jtgebert/fpganes_release/documents/README.md

*Four People Generating A Nintendo Entertainment System (FPGANES)*

*Eric Sullivan, Jonathan Ebert, Patrick Yang, Pavan Holla*

<span id="_byhn74w1sckk" class="anchor"></span>Final Report

University of Wisconsin-Madison

ECE 554

Spring 2017

Introduction
============

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

1.  Top Level Block Diagram
    =======================

    1.  Top level description
        ---------------------

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

6.  APU - Generates audio in the NES. However, we did not implement this module.

7.  CHAR RAM/ RAM - Used by the CPU and PPU to store temporary data

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

Data Flow Diagram
-----------------



Figure 1: System level data flow diagram

 Control Flow Diagram
---------------------



Figure 2: System level control flow diagram.

CPU
===

CPU Registers
-------------

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

1.  PC : Program Counter

2.  Accumulator(A) : Keeps track of results from ALU

3.  X : X index register

4.  Y : Y index register

5.  Stack pointer

6.  Status Register : Negative, Overflow, Unused, Break, Decimal, Interrupt, Zero, Carry

    -   Break means that the current interrupt is from software interrupt, BRK

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

There are 6 secondary registers:

1.  AD : Address Register

    -   Stores where to jump to or where to get indirect access from.

2.  ADV : AD Value Register

    -   Stores the value from indirect access by AD.

3.  BA : Base Address Register

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

4.  BAV : BA Value Register

    -   Stores the value from indirect access by BA.

5.  IMM : Immediate Register

    -   Stores the immediate value from the memory.

6.  Offset

    -   Stores the offset value of branch from memory

CPU ISA
-------

The ISA may be classified into a few broad operations:

-   Load into A,X,Y registers from memory

-   Perform arithmetic operation on A,X or Y

-   Move data from one register to another

-   Program control instructions like Jump and Branch

-   Stack operations

-   Complex instructions that read, modify and write back memory.

CPU Addressing Modes
--------------------

Additionally, there are thirteen addressing modes which these operations can use. They are

-   **Accumulator** – The data in the accumulator is used.

-   **Immediate** - The byte in memory immediately following the instruction is used.

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

-   **Zero Page, Y Index** – Same as above but with the Y index register

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

-   **Absolute, Y Index** – Same as above but with the Y index register

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

-   **(Indirect, X)** – A combination of Indirect Addressing and Indexed Addressing

-   **(Indirect), Y** - A combination of Indirect Addressing and Indexed Addressing

CPU Interrupts
--------------

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

CPU Opcode Matrix
-----------------

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

The specific opcode hex values are specified in the Assembler section.

For more information on the opcodes, please refer

[*http://www.6502.org/tutorials/6502opcodes.html*](http://www.6502.org/tutorials/6502opcodes.html)

or

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

CPU Block Diagram
------------------------------------------------------------------------

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

**Instruction flow**

The following table presents a high level overview of how each instruction is handled.

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

**State Machines**

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

Instruction\_type=ARITHMETIC, addressing mode= IMMEDIATE

| state=0 | state=1 | state=2 |
|---|---|---|
| ld\_sel=LD\_INSTR; //instr= memory\_data 
                                           
 pc\_sel=INC\_PC; //pc++                   
                                           
 next\_state=state+1’b1                    | ld\_sel=LD\_IMM;       
                          
  //imm=memory\_data      
                          
  pc\_sel=INC\_PC         
                          
  next\_state=state+1’b1  | alu\_ctrl=DO\_OP\_ADC // execute          
                                              
   src1\_sel=SRC1\_A                          
                                              
   src2\_sel=SRC2\_IMM                        
                                              
   dest\_sel=DEST\_A                          
                                              
   ld\_sel=LD\_INSTR//fetch next instruction  
                                              
   pc\_sel=INC\_PC                            
                                              
   next\_state=1’b1                           |

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

CPU Top Level Interface
-----------------------

| Signal name | Signal Type | Source/Dest | Description |
|---|---|---|---|
| clk | input | | System clock |
| rst | input | | System active high reset |
| nmi | input | PPU | Non maskable interrupt from PPU. Executes BRK instruction in CPU |
| addr\[15:0\]  | output | RAM | Address for R/W issued by CPU |
| dout\[7:0\] | input/ 
               
  output       | RAM         | Data from the RAM in case of reads and and to the RAM in case of writes |
| memory\_read  | output      | RAM         | read enable signal for RAM                                              |
| memory\_write | output      | RAM         | write enable signal for RAM                                             |

CPU Instruction Decode Interface
--------------------------------

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

CPU MEM Interface
-----------------

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

CPU ALU Interface
-----------------

Performs arithmetic, logical operations and operations that involve status registers.

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

### ALU Input Selector

Selects the input1 and input2 for the ALU

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

CPU Registers Interface
-----------------------

Holds all of the registers

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

CPU Processor Control Interface
-------------------------------

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

CPU Enums
---------

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

Picture Processing Unit
=======================

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

PPU Top Level Schematic
-----------------------



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

**Background Renderer:** Responsible for drawing the background data for a scene.

**Sprite Renderer:** Responsible for drawing the sprite data for a scene, and maintaining object attribute memory.

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

PPU Memory Map
--------------



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

PPU CHAROM
----------

-   ROM from the cartridge is broken in two sections

    -   Program ROM

        -   Contains program code for the 6502

        -   Is mapped into the CPU address space by the mapper

    -   Character ROM

        -   Contains sprite and background data for the PPU

        -   Is mapped into the PPU address space by the mapper

PPU Rendering
-------------

-   Pattern Tables

    -   $0000-$2000 in VRAM

        -   Pattern Table 0 ($0000-$0FFF)

        -   Pattern Table 1 ($1000-$2000)

        -   The program selects which one of these contains sprites and backgrounds

        -   Each pattern table is 16 bytes long and represents 1 8x8 pixel tile

            -   Each 8x1 row is 2 bytes long

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

                -   Color\_pixel = {byte2\[0\], byte1\[0\]}

            -   So there can only be 4 colors in any given tile

            -   Rightmost bit is leftmost pixel

    -   Any pattern that has a value of 0 is transparent i.e. the background color



-   Name Tables

    -   $2000-$2FFF in VRAM with $3000-$3EFF as a mirror

    -   Laid out in memory in 32x30 fashion

        -   Think of as a 2d array where each element specifies a tile in the pattern table.

        -   This results in a resolution of 256x240

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

        -   Vertically = horizontal movement

        -   Horizontally = vertical movement

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

    -   Attribute tables

        -   1 byte entries that contains the palette assignment for a 2x2 grid of tiles

> 

-   Sprites

    -   Just like backgrounds sprite tile data is contained in one of the pattern tables

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

-   Object Attribute Memory

    -   256 bytes of dedicated RAM

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

    -   Each object has the following information stored in OAM

        -   X Coordinate

        -   Y Coordinate

        -   Pattern Table Index

        -   Palette Assignment

        -   Horizontal/Vertical Flip

-   Palette Table

    -   Located at $3F00-$3F20

        -   $3F00-$3F0F is background palettes

        -   $3F10-$3F1F is sprite palettes

    -   Mirrored all the way to $4000

    -   Each color takes one byte

    -   Every background tile and sprite needs a color palette.

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

-   Rendering is broken into two parts which are done for each horizontal scanline

    -   Background Rendering

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

        -   The background data is obtained for every pixel.

    -   Sprite Rendering

        -   The sprite renderer has room for 8 unique sprites on each scanline.

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

            -   If this number exceeds 8 a flag is set and the behavior is undefined.

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

PPU Memory Mapped Registers
---------------------------

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

PPU Register Block Diagram
--------------------------

Untitled Diagram.png

PPU Register Descriptions
-------------------------

-   Control registers are mapped into the CPUs address space ($2000 - $2007)

-   The registers are repeated every eight bytes until address $3FF

-   **PPUCTRL\[7:0\] (**$2000) WRITE

    -   \[1:0\]: Base nametable address which is loaded at the start of a frame

        -   0: $2000

        -   1: $2400

        -   2: $2800

        -   3: $2C00

    -   \[2\]: VRAM address increment per CPU read/write of PPUDATA

        -   0: Add 1 going across

        -   1: Add 32 going down

    -   \[3\]: Sprite pattern table for 8x8 sprites

        -   0: $0000

        -   1: $1000

        -   Ignored in 8x16 sprite mode

    -   \[4\]: Background pattern table address

        -   0: $0000

        -   1: $1000

    -   \[5\]: Sprite size

        -   0: 8x8

        -   1: 8x16

    -   \[6\]: PPU master/slave select

        -   0: Read backdrop from EXT pins

        -   1: Output color on EXT pins

    -   \[7\]: Generate NMI interrupt at the start of vertical blanking interval

        -   0: off

        -   1: on

-   **PPUMASK\[7:0\]** ($2001) WRITE

    -   \[0\]: Use grayscale image

        -   0: Normal color

        -   1: Grayscale

    -   \[1\]: Show left 8 pixels of background

        -   0: Hide

        -   1: Show background in leftmost 8 pixels of screen

    -   \[2\]: Show left 8 piexels of sprites

        -   0: Hide

        -   1: Show sprites in leftmost 8 pixels of screen

    -   \[3\]: Render the background

        -   0: Don’t show background

        -   1: Show background

    -   \[4\]: Render the sprites

        -   0: Don’t show sprites

        -   1: Show sprites

    -   \[5\]: Emphasize red

    -   \[6\]: Emphasize green

    -   \[7\]: Emphasize blue

-   **PPUSTATUS\[7:0\]** ($2002) READ

    -   \[4:0\]: Nothing?

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

    -   \[7\]: Vertical blank status register

        -   0: Not in vertical blank

        -   1: Currently in vertical blank

-   **OAMADDR\[7:0\]** ($2003) WRITE

    -   Address of the object attribute memory the program wants to access

-   **OAMDATA\[7:0\]** ($2004) READ/WRITE

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

-   **PPUSCROLL\[7:0\]** ($2005) WRITE

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

-   **PPUADDR\[7:0\]** ($2006) WRITE

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

-   **PPUDATA\[7:0\]** ($2007) READ/WRITE

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

-   **OAMDMA\[7:0\]** ($4014) WRITE

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

PPU Background Renderer
-----------------------

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

PPU Background Renderer Diagram
-------------------------------

Untitled Diagram.png

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

PPU Sprite Renderer
-------------------

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

PPU Sprite Renderer Diagram
---------------------------

Untitled Diagram.png

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

PPU Object Attribute Memory
---------------------------

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

PPU Palette Memory
------------------

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

VRAM Interface
--------------

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

DMA
---

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

PPU Testbench
-------------

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

Untitled Diagram.png

Untitled Diagram.png

PPU Testbench PPM file format
-----------------------------

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

PPU Testbench Example Renderings
--------------------------------

test (1).pngtest (2).pngtest (3).pngtest (4).pngtest (5).pngtest (10).png

Memory Maps
===========

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

PPU ROM Memory Map
------------------

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

CPU ROM Memory Map
------------------

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

Memory Mappers Interface
------------------------

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

APU
===

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

 APU Registers
--------------

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

Controllers (SPART)
===================

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

Debug Modification
------------------

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

Controller Registers
--------------------

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

Controllers Wrapper
-------------------

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

### Controller Wrapper Diagram

### Controller Wrapper Interface

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

Controller
----------

The controller module instantiates the Driver and SPART module’s.

### Controller Diagram

### Controller Interface

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

Special Purpose Asynchronous Receiver and Transmitter (SPART)
-------------------------------------------------------------

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

SPART Diagram & Interface

### 

Controller Driver
-----------------

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

### Controller Driver State Machine

VGA
===

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

> 

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

VGA Diagram
-----------

VGA Interface
-------------

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

VGA Clock Gen
-------------

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

VGA Timing Gen
--------------

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

VGA Display Plane
-----------------

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

VGA RAM Wrapper
---------------

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

VGA RAM Reader
--------------

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

Software
========

Controller Simulator
--------------------

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

### Controller Simulator State Machine 

### Controller Simulator Output Packet Format

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

### Controller Simulator GUI and Button Map

The NES controller had a total of 8 buttons, as shown below.



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

Assembler
---------

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

### Opcode Table

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

### NES Assembly Formats

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

### 

### Invoking Assembler

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

 iNES ROM Converter
-------------------

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

 Tic Tac Toe
------------

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

Testing & Debug
===============

Our debugging process had multiple steps

Simulation
----------

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

Test
----

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

Integrated Simulation
---------------------

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

Tracer
------

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

Results
=======

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

Possible Improvements
=====================

-   Create a working audio processing unit

-   More advanced memory mapper support

-   Better image upscaling such as hqx

-   Support for actual NES game carts

-   HDMI

-   VGA buffer instead of two RAM blocks to save space

References and Links
====================

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

Contributions
=============

Eric Sullivan
-------------

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

Patrick Yang
------------

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

Pavan Holla
-----------

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

Jonathan Ebert
--------------

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
