jtgebert/fpganes_release/documents/Microarch review.pptx

## FPGANES

## Top level

## Slide 3

## Slide 4

Cycle Number | Blocks | Action
0 | Processor Control → Registers | Instruction Fetch
1 | Register → Decode | Classify instruction and addressing mode
1 | Decode → Processor Control | Init state machine
2-6 | Processor Control → Registers | Populate scratch registers based on addressing mode.
Last Cycle | Processor Control → ALU | Execute
Last Cycle | Processor Control → Registers | Instruction Fetch
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
