jtgebert/fpganes_release/src/sw/Controller/img/NESController.png

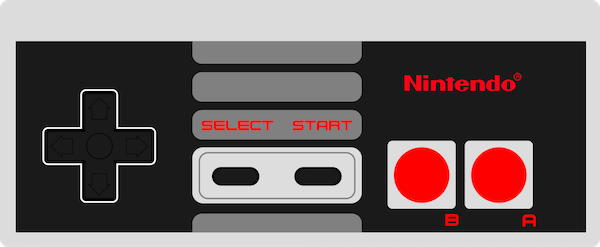
src/sw/Controller/img/NESController.png
