jtgebert/fpganes_release/src/hw/CPU/cpu_switchcase.sv

case( { instruction_type, addressing_mode } )
	{STA,ZEROPAGE}:  begin
		case(state)
			0:  begin
				ld_sel=LD_INSTR;
				pc_sel=INC_PC;
				next_state=state+1'b1;
				end
			1:  begin
				ld_sel=LD_ADL;
				clr_adh=1;
				pc_sel=INC_PC;
				next_state=state+1'b1;
				end
			2:  begin
				addr_sel=ADDR_AD;
				st_sel=ST_A;
				pc_sel=KEEP_PC;
				next_state=state+1'b1;
				end
			3:  begin
				nop_cycle=1'b1;
				next_state=1'b1;
				ld_sel=LD_INSTR;
				pc_sel=INC_PC;
				end
default : begin /* do nothing */ end
		endcase
	end
	{STA,ZEROPAGE_INDEX}:  begin
		case(state)
			0:  begin
				ld_sel=LD_INSTR;
				pc_sel=INC_PC;
				next_state=state+1'b1;
				end
			1:  begin
				ld_sel=LD_BAL;
				pc_sel=INC_PC;
				clr_bah=1;
				next_state=state+1'b1;
				end
			2:  begin
				alu_mode=ALUMODE_FLAGLESS;
				src1_sel=SRC1_BAL;
				src2_sel=SRC2_X;
				dest_sel=DEST_BAL;
				pc_sel=KEEP_PC;
				next_state=state+1'b1;
				end
			3:  begin
				addr_sel=ADDR_BA;
				st_sel=ST_A;
				pc_sel=KEEP_PC;
				next_state=state+1'b1;
				end
			4:  begin
				nop_cycle=1'b1;
				next_state=1'b1;
				ld_sel=LD_INSTR;
				pc_sel=INC_PC;
				end
default : begin /* do nothing */ end
		endcase
	end
	{STA,ABSOLUTE}:  begin
		case(state)
			0:  begin
				ld_sel=LD_INSTR;
				pc_sel=INC_PC;
				next_state=state+1'b1;
				end
			1:  begin
				ld_sel=LD_ADL;
				pc_sel=INC_PC;
				next_state=state+1'b1;
				end
			2:  begin
				ld_sel=LD_ADH;
				pc_sel=INC_PC;
				next_state=state+1'b1;
				end
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
		case(state)
			0:  begin
				ld_sel=LD_INSTR;
				pc_sel=INC_PC;
				next_state=state+1'b1;
				end
			1:  begin
				ld_sel=LD_ADL;
				pc_sel=INC_PC;
				next_state=state+1'b1;
				end
			2:  begin
				ld_sel=LD_ADH;
				pc_sel=INC_PC;
				next_state=state+1'b1;
				end
			3:  begin
				addr_sel=ADDR_AD;
				ld_sel=LD_ADV;
				pc_sel=KEEP_PC;
				next_state=state+1'b1;
				end
			4:  begin
				alu_mode=ALUMODE_DECODER;
				src1_sel=SRC1_ADV;
				src2_sel=SRC2_DC;
				dest_sel=DEST_ADV;
				next_state=state+1'b1;
				end
			5:  begin
				addr_sel=ADDR_AD;
				st_sel=ST_ADV;
				next_state=state+1'b1;
				end
			6:  begin
				nop_cycle=1'b1;
				next_state=1'b1;
				ld_sel=LD_INSTR;
				pc_sel=INC_PC;
				end
default : begin /* do nothing */ end
		endcase
	end
	{MANIPULATION,ABSOLUTE_INDEX}:  begin
		case(state)
			0:  begin
				ld_sel=LD_INSTR;
				pc_sel=INC_PC;
				next_state=state+1'b1;
				end
			1:  begin
				ld_sel=LD_BAL;
				pc_sel=INC_PC;
				next_state=state+1'b1;
				end
			2:  begin
				ld_sel=LD_BAH;
				pc_sel=INC_PC;
				alu_mode=ALUMODE_FLAGLESS;
				src1_sel=SRC1_BAL;
				src2_sel=SRC2_X;
				dest_sel=DEST_BAL;
				next_state=state+1'b1;
				end
			3:  begin
				alu_mode=ALUMODE_FLAGLESS;
				src1_sel=SRC1_BAH;
				src2_sel=SRC2_T_C;
				dest_sel=DEST_BAH;
				next_state=state+1'b1;
				end
			4:  begin
				addr_sel=ADDR_BA;
				ld_sel=LD_BAV;
				pc_sel=KEEP_PC;
				next_state=state+1'b1;
				end
			5:  begin
				alu_mode=ALUMODE_DECODER;
				src1_sel=SRC1_BAV;
				src2_sel=SRC2_DC;
				dest_sel=DEST_BAV;
				next_state=state+1'b1;
				end
			6:  begin
				addr_sel=ADDR_BA;
				st_sel=ST_BAV;
				next_state=state+1'b1;
				end
			7:  begin
				nop_cycle=1'b1;
				next_state=1'b1;
				ld_sel=LD_INSTR;
				pc_sel=INC_PC;
				end
default : begin /* do nothing */ end
		endcase
	end
endcase
