jtgebert/fpganes_release/src/hw/VGA/Testing/VGARAM_test_inst.v

VGARAM_test	VGARAM_test_inst (
	.data ( data_sig ),
	.rdaddress ( rdaddress_sig ),
	.rdclock ( rdclock_sig ),
	.rden ( rden_sig ),
	.wraddress ( wraddress_sig ),
	.wrclock ( wrclock_sig ),
	.wren ( wren_sig ),
	.q ( q_sig )
	);
