jtgebert/fpganes_release/src/sw/Assembler/tests/allInstructions.asm

_CPU:

; ADC
ADC #1;
ADC $01;
ADC $01, X;
ADC $0001;
ADC $0001, X;
ADC $0001, Y;
ADC ($01, X);
ADC ($01), Y;
AND #1;
AND $01;
AND $01, X;
AND $0001;
AND $0001, X
AND $0001, Y
AND ($01, X);
AND ($01), Y;
ASL;
ASL $01;
ASL $01, X;
ASL $0001;
ASL $0001, X;
BCC $01;
BCS $01;
BEQ $01;
BIT $01;
BIT $0001;
BMI $01;
BNE $01;
BPL $01;
BRK;
BVC $01;
BVS $01;
CLC;
CLD;
CLI;
CLV;
CMP #$01;
CMP $01;
CMP $01, X;
CMP $0001;
CMP $0001, X;
CMP $0001, Y;
CMP ($01, X);
CMP ($01), Y;
CPX #$01;
CPX $01;
CPX $0001;
CPY #$01;
CPY $01;
CPY $0001;
DEC $01;
DEC $01, X;
DEC $0001;
DEC $0001, X;
DEX;
DEY;
EOR #$01;
EOR $01;
EOR $01, X;
EOR $0001;
EOR $0001, X;
EOR $0001, Y;
EOR ($01, X);
EOR ($01), Y;
INC $01;
INC $01, X;
INC $0001;
INC $0001, X;
INX;
INY;
JMP ($0001);
JMP $0001;
JSR $0001;
LDA #$01;
LDA $01;
LDA $01, X;
LDA $0001;
LDA $0001, X;
LDA $0001, Y;
LDA ($01, X);
LDA ($01), Y;
LDX #$01;
LDX $01;
LDX $01, Y;
LDX $0001;
LDX $0001, Y;
LDY #$01;
LDY $01;
LDY $01, X;
LDY $0001;
LDY $0001, X;
LSR;
LSR $01;
LSR $01, X;
LSR $0001;
LSR $0001, X;
NOP;
ORA #$01;
ORA $01;
ORA $01, X;
ORA $0001;
ORA $0001, X;
ORA $0001, Y;
ORA ($01, X);
ORA ($01), Y;
PHA;
PHP;
PLA;
PLP;
ROL;
ROL $01;
ROL $01, X;
ROL $0001;
ROL $0001, X;
ROR;
ROR $01;
ROR $01, X;
ROR $0001;
ROR $0001, X;
RTI;
RTS;
SBC #$01;
SBC $01;
SBC $01, X;
SBC $0001;
SBC $0001, X;
SBC $0001, Y;
SBC ($01, X);
SBC ($01), Y;
SEC;
SED;
SEI;
STA $01;
STA $01, X;
STA $0001;
STA $0001, X;
STA $0001, Y;
STA ($01, X);
STA ($01), Y;
STX $01;
STX $01, Y;
STX $0001;
STY $01;
STY $01, X;
STY $0001;
TAX;
TAY;
TSX;
TXA;
TXS;
TYA;

_PPU:
